ringedSquid/Hands_Free_Mouse_SSCS-2025/cad_files/Main Assembly.step

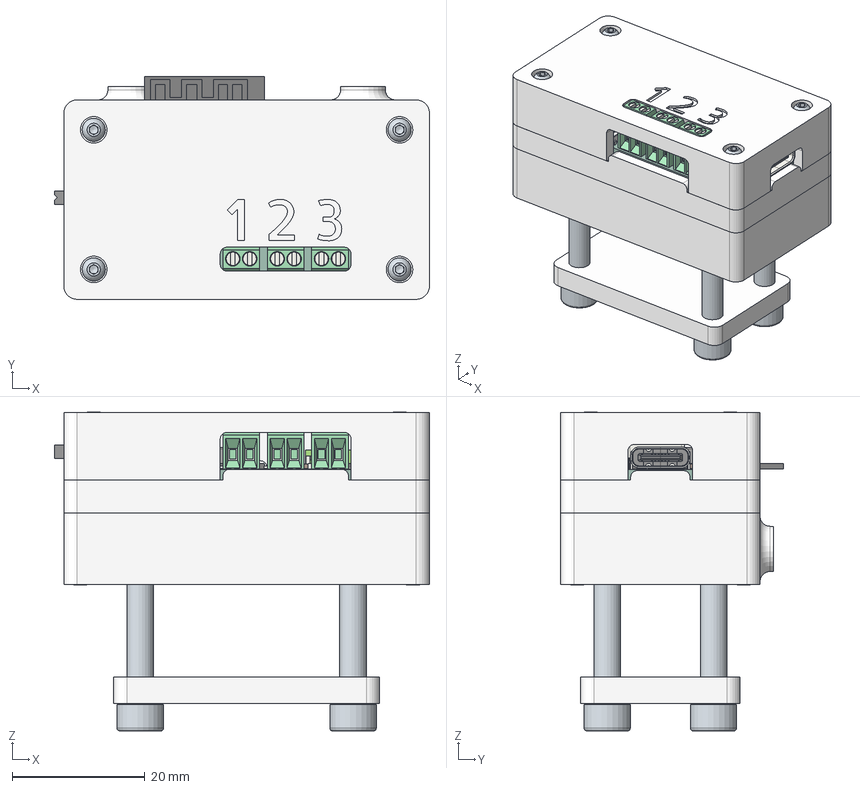
[picture p1: CAD file, 2025-07-31]
cad_files/Main Assembly.step
56.4 x 33.5 x 48.0 mm
Socket button head screw M2x0.4 x 12 x 8
Hex socket head cap screw M4x0.70 x 20 x 4
Top Case
Bottom Case
Mounting Plate
Battery Case
C_0603_1608Metric x 11
R_0603_1608Metric x 15
_autosave-schematics_PCB
C_0805_2012Metric x 3
JST_B2B_PH_K
TerminalBlock_Phoenix_MPT_05_2_254_1x02_P254mm_Horizontal x 3
Bosch_LGA_14_3x25mm_P05mm
SW_SPST_EVQP2 x 2
SOT_23_5 x 2
WSON_6_1EP_2x2mm_P065mm_EP1x16mm
TSOT_23_5
LED_D1.8mm_W1.8mm_H2.4mm_Horizontal_O1.27mm_Z1.6mm x 2
SW_Slide_SPDT_Angled_CK_OS102011MA1Q x 6
USB_C_Receptacle_16P_TopMnt_Horizontal_GCT_USB4105-xx-A x 36
ESP32-C3-WROOM-02 x 30
