ringedSquid/Hands_Free_Mouse_SSCS-2025/cad_files/Enclosure Parts - Battery Case.step

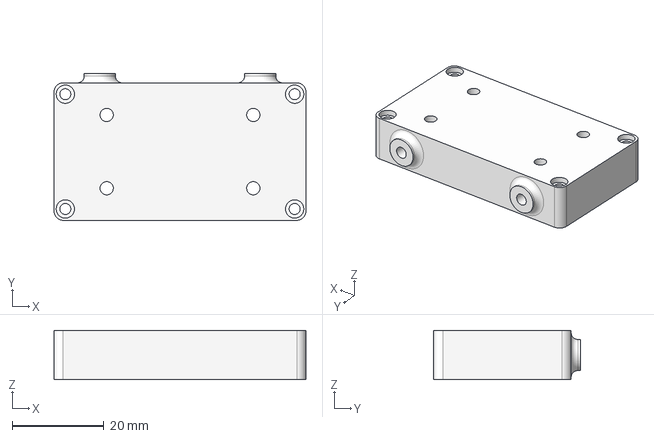
[picture p2: CAD file, 2025-07-31]
cad_files/Enclosure Parts - Battery Case.step
55.0 x 32.0 x 10.8 mm
