ringedSquid/Hands_Free_Mouse_SSCS-2025/schematics/schematics.step

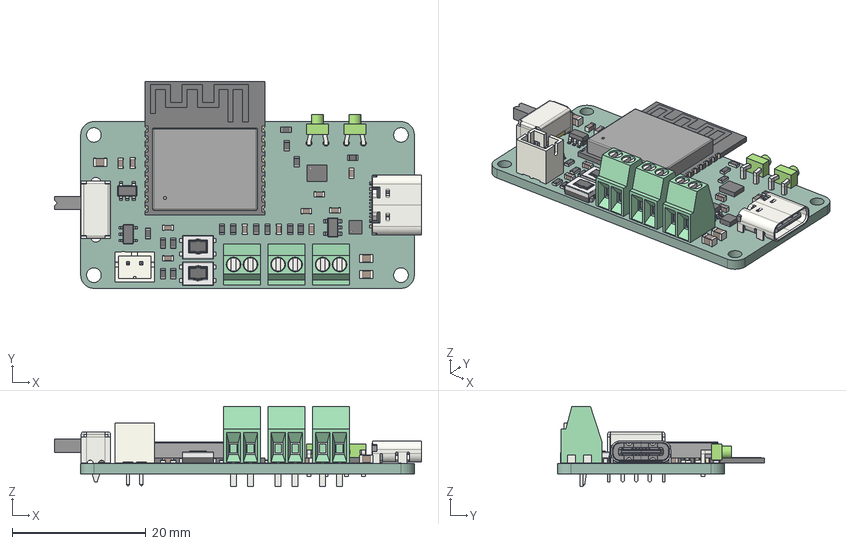
[picture p3: CAD file, 2025-07-23]
schematics/schematics.step
55.0 x 31.0 x 12.0 mm
C_0603_1608Metric x 11
R_0603_1608Metric x 15
TerminalBlock_Phoenix_MPT_05_2_254_1x02_P254mm_Horizontal x 3
C_0805_2012Metric x 3
SW_SPST_EVQP2 x 2
USB_C_Receptacle_16P_TopMnt_Horizontal_GCT_USB4105-xx-A
WSON_6_1EP_2x2mm_P065mm_EP1x16mm
SOT_23_5 x 2
LED_D1.8mm_W1.8mm_H2.4mm_Horizontal_O1.27mm_Z1.6mm x 2
JST_B2B_PH_K
Bosch_LGA_14_3x25mm_P05mm
SW_Slide_SPDT_Angled_CK_OS102011MA1Q
ESP32-C3-WROOM-02
TSOT_23_5
_autosave-schematics_PCB
