ringedSquid/Hands_Free_Mouse_SSCS-2025/cad_files/Enclosure Parts - Mounting Plate.step

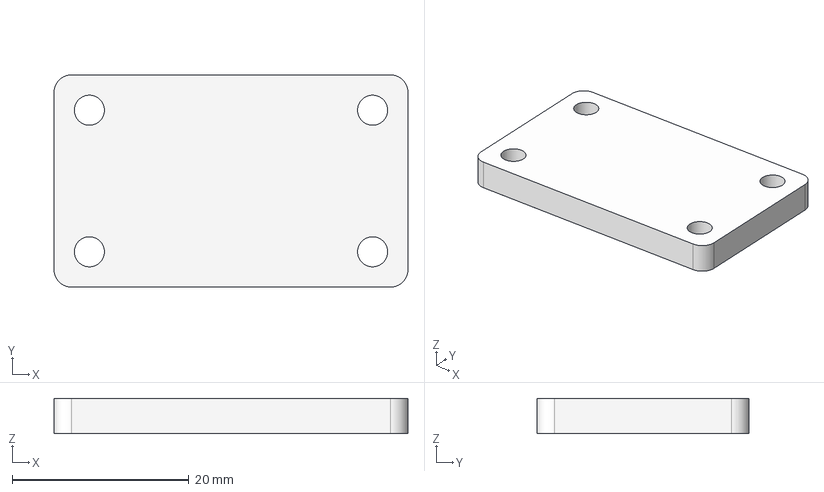
[picture p4: CAD file, 2025-07-31]
cad_files/Enclosure Parts - Mounting Plate.step
40.0 x 24.0 x 4.00 mm
