ringedSquid/Hands_Free_Mouse_SSCS-2025/cad_files/Enclosure Parts - Bottom Case.step

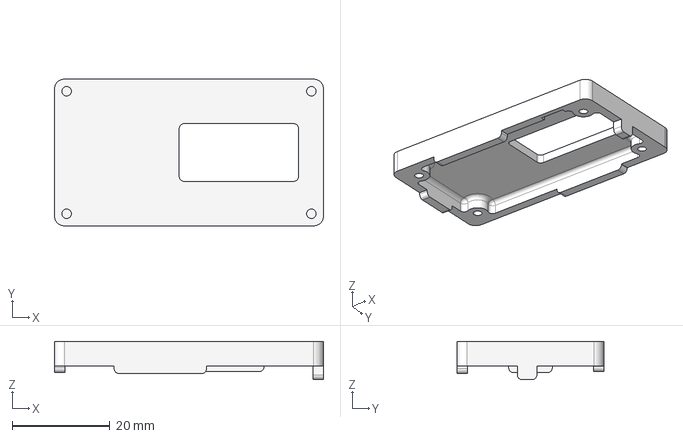
[picture p5: CAD file, 2025-07-31]
cad_files/Enclosure Parts - Bottom Case.step
55.0 x 30.0 x 7.85 mm
