ringedSquid/Hands_Free_Mouse_SSCS-2025/cad_files/Enclosure Parts - Top Case.step

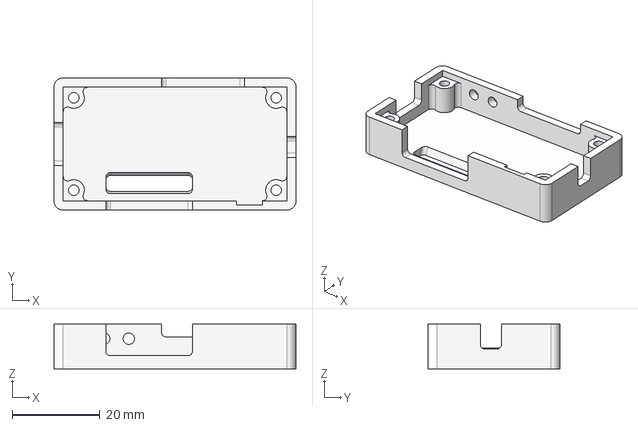
[picture p6: CAD file, 2025-07-31]
cad_files/Enclosure Parts - Top Case.step
55.0 x 30.0 x 10.1 mm
