ringedSquid/Hands_Free_Mouse_SSCS-2025/schematics/schematics.kicad_pcb

## KiCad design schematics/schematics.kicad_pcb (2025-07-23)

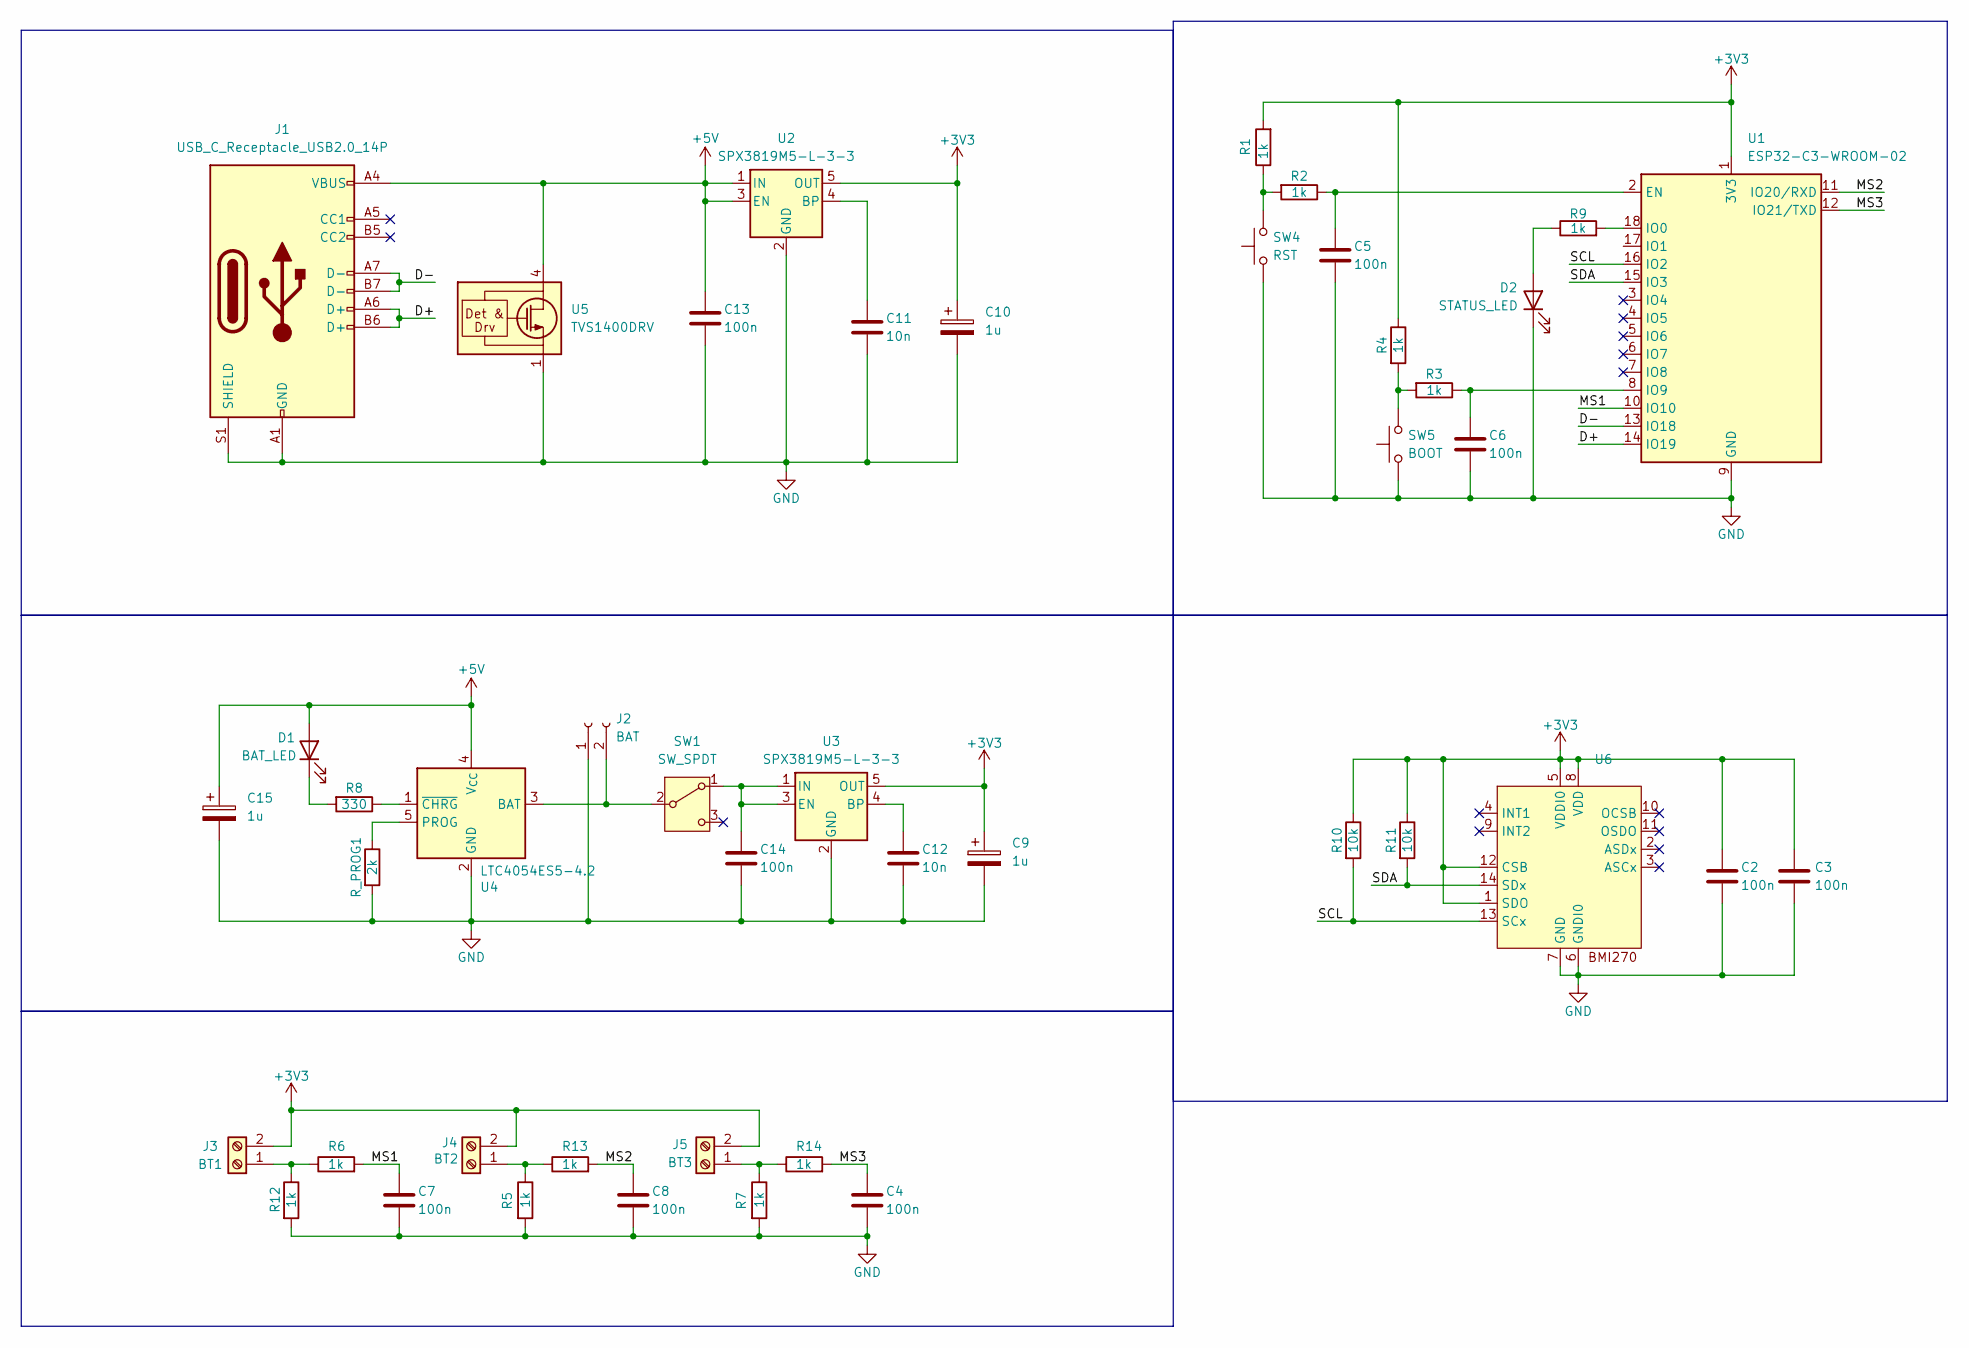
[picture p7: schematic schematics.kicad_sch]

Parts:
C2, C3, C4, C5, C6, C7, C8, C13, C14: 100n; C_0603_1608Metric
C9, C10, C15: 1u; C_0805_2012Metric
C11, C12: 10n; C_0603_1608Metric
D1: BAT_LED; LED_D1.8mm_W1.8mm_H2.4mm_Horizontal_O1.27mm_Z1.6mm
D2: STATUS_LED; LED_D1.8mm_W1.8mm_H2.4mm_Horizontal_O1.27mm_Z1.6mm
J1: USB_C_Receptacle_USB2.0_14P; USB_C_Receptacle_GCT_USB4110
J2: BAT; JST_PH_B2B-PH-K_1x02_P2.00mm_Vertical
J3: BT1; TerminalBlock_Phoenix_MPT-0,5-2-2.54_1x02_P2.54mm_Horizontal
J4: BT2; TerminalBlock_Phoenix_MPT-0,5-2-2.54_1x02_P2.54mm_Horizontal
J5: BT3; TerminalBlock_Phoenix_MPT-0,5-2-2.54_1x02_P2.54mm_Horizontal
R1, R2, R3, R4, R5, R6, R7, R9, R12, R13, R14: 1k; R_0603_1608Metric
R8: 330; R_0603_1608Metric
R10, R11: 10k; R_0603_1608Metric
R_PROG1: 2k; R_0603_1608Metric
SW1: SW_SPDT; SW_Slide_SPDT_Angled_CK_OS102011MA1Q
SW4: RST; SW_Push_1P1T_NO_CK_KMR2
SW5: BOOT; SW_Push_1P1T_NO_CK_KMR2
U1: ESP32-C3-WROOM-02
U2, U3: SPX3819M5-L-3-3; SOT-23-5
U4: LTC4054ES5-4.2; TSOT-23-5
U5: TVS1400DRV; WSON-6-1EP_2x2mm_P0.65mm_EP1x1.6mm
U6: Bosch_LGA-14_3x2.5mm_P0.5mm

Connections:
+3V3: C2.1, C3.1, C9.1, C10.1, J3.2, J4.2, J5.2, R1.2, R4.1, R10.1, R11.1, U1.1 (3V3), U2.5 (OUT), U3.5 (OUT), U6.1 (SDO), U6.5 (VDDI0), U6.8 (VDD), U6.12 (CSB)
+5V: C13.1, C15.1, D1.2 (A), J1.A4 (VBUS), J1.A9 (VBUS), J1.B4 (VBUS), J1.B9 (VBUS), U2.1 (IN), U2.3 (EN), U4.4 (V_{CC}), U5.4 (IN), U5.5 (IN), U5.6 (IN)
/D+: J1.A6 (D+), J1.B6 (D+), U1.14 (IO19)
/D-: J1.A7 (D-), J1.B7 (D-), U1.13 (IO18)
/MS1: C7.1, R6.2, U1.10 (IO10)
/MS2: C8.1, R13.2, U1.11 (IO20/RXD)
/MS3: C4.1, R14.2, U1.12 (IO21/TXD)
/SCL: R10.2, U1.16 (IO2), U6.13 (SCx)
/SDA: R11.2, U1.15 (IO3), U6.14 (SDx)
GND: C2.2, C3.2, C4.2, C5.2, C6.2, C7.2, C8.2, C9.2, C10.2, C11.2, C12.2, C13.2, C14.2, C15.2, D2.1 (K), J1.A1 (GND), J1.A12 (GND), J1.B1 (GND), J1.B12 (GND), J1.S1 (SHIELD), J2.1, R5.2, R7.2, R12.2, R_PROG1.2, SW4.1, SW5.1, U1.9 (GND), U1.19 (GND), U2.2 (GND), U3.2 (GND), U4.2 (GND), U5.1 (GND), U5.2 (GND), U5.3 (GND), U5.7 (GND), U6.6 (GNDI0), U6.7 (GND)
unnamed: D1.1 (K), R8.2
unnamed: D2.2 (A), R9.1
unnamed: J2.2, SW1.2 (B), U4.3 (BAT)
unnamed: J3.1, R6.1, R12.1
unnamed: J4.1, R5.1, R13.1
unnamed: J5.1, R7.1, R14.1
unnamed: R1.1, R2.2, SW4.2
unnamed: R3.2, R4.2, SW5.2
unnamed: C14.1, SW1.1 (A), U3.1 (IN), U3.3 (EN)
unnamed: C5.1, R2.1, U1.2 (EN)
unnamed: R9.2, U1.18 (IO0)
unnamed: C6.1, R3.1, U1.8 (IO9)
unnamed: C11.1, U2.4 (BP)
unnamed: C12.1, U3.4 (BP)
unnamed: R_PROG1.1, U4.5 (PROG)
unnamed: R8.1, U4.1 (~CHRG)

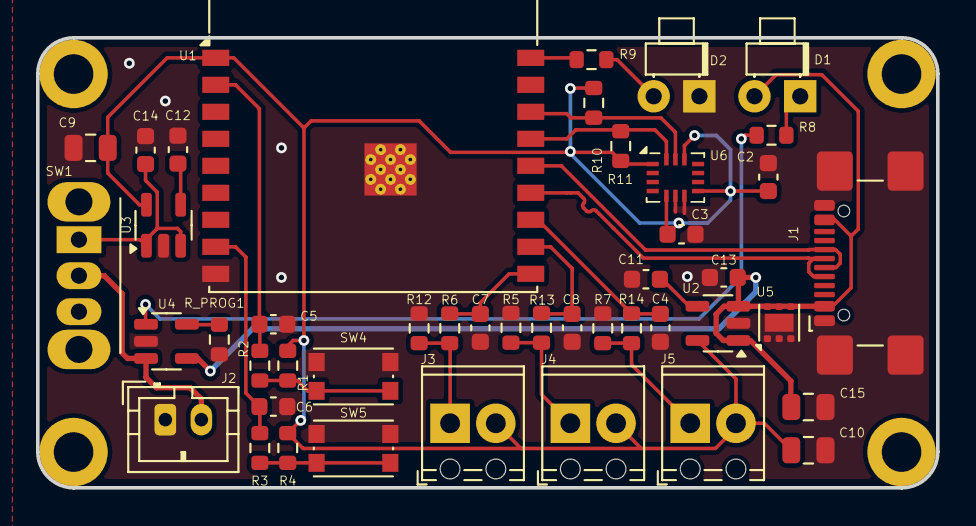
[picture p8: board schematics.kicad_pcb from above]

Board: 2 copper layers, 50.0 x 25.0 mm, 45 parts (0 on the bottom side), 26 nets.
