ringedSquid/Hands_Free_Mouse_SSCS-2025/(commit log)

2025-07-10 added kicad file
    [schematics.kicad_pcb, schematics.kicad_sch]
2025-07-10 completed schematics, need to start routing to decide I2C and button pinouts
    [schematics.kicad_sch]
2025-07-15 initial electronics
    [schematics.kicad_pcb, schematics.kicad_sch]
2025-07-15 completed electronics, ordered parts
    [schematics-B_Cu.gbr, schematics-B_Mask.gbr, schematics-B_Paste.gbr, schematics-B_Silkscreen.gbr, schematics-Edge_Cuts.gbr, schematics-F_Cu.gbr, schematics-F_Mask.gbr, schematics-F_Paste.gbr]
2025-07-23 fix i2c pins
    [schematics.kicad_pcb, schematics.kicad_sch, schematics.step]
2025-07-30 mouse working need to add buttons in hardware and software
2025-07-31 add cad files
    [Enclosure Parts - Battery Case.step, Enclosure Parts - Bottom Case.step, Enclosure Parts - Mounting Plate.step, Enclosure Parts - Top Case.step, Main Assembly.step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]
